ElektronikaDonBosco/Estaci-n-Meteorol-gica/README.md

# ESTACIÓN METEOROLÓGICA

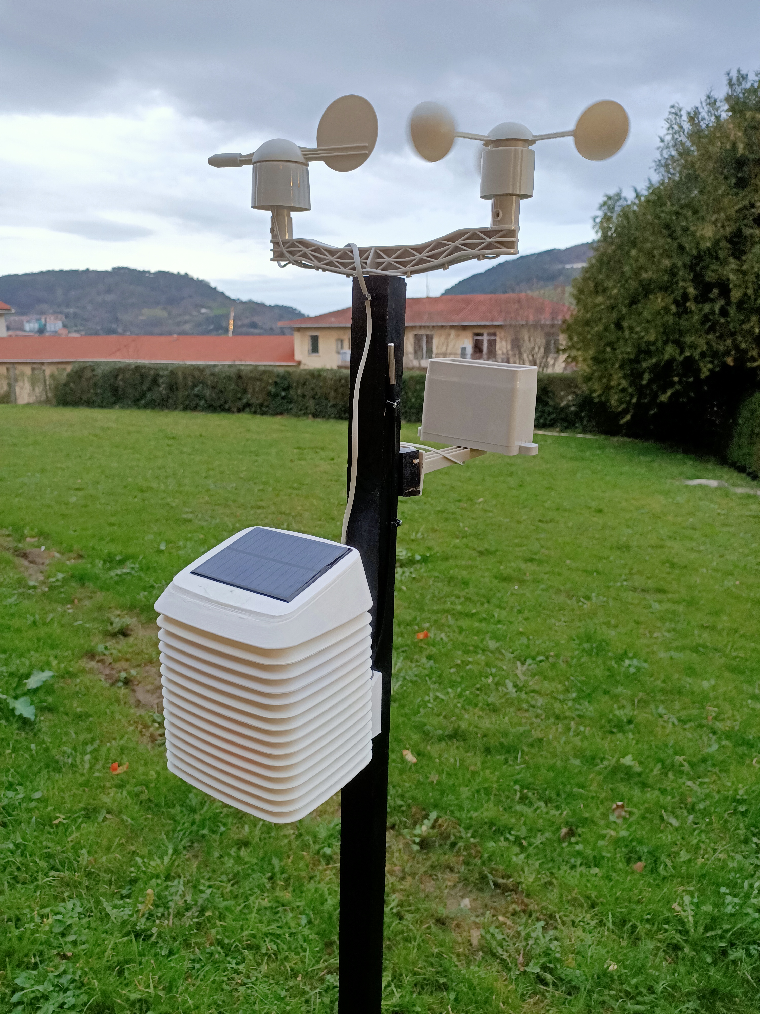
[picture p1: Foto estacion meteorologica.jpg]


## Pasos a seguir para crear una estación meteorológica
Para este proyecto  vamos a aprender cómo hacer una estación meteorológica inalámbrica alimentada mediante  energía solar , con  el uso de un módulo Wifi ESP32 y algunos sensores  lograremos tener información en tiempo real . 

La ventaja de tener una estación meteorológica es que no necesita  estar conectada a una fuente de corriente constante por lo que ahorraremos mucha energía y además puede establecerse en lugares remotos , otra ventaja que tiene es que podemos comprar estos componentes a un precio reducido con lo cual recortamos muchos gastos y hace que se muy asequible .

Para hacer posible esta estación meteorológica vamos a necesitar los siguientes componentes:

***

> **CHIPS**                     
* [BME280](https://www.amazon.com/Dmyond-Atmospheric-Pressure-Temperature-Humidity/dp/B07XKSBQ9B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) 
* [DS18B20](https://www.amazon.com/DS18B20-Temperature-Waterproof-Digital-Thermal/dp/B085WBVZHN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)
* [BH1750](https://www.amazon.com/HiLetgo-GY-302-BH1750-Intensity-Illumination/dp/B00M0F29OS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)
* [ESP32 Dev Kit V1 - 30 Pins](https://es.aliexpress.com/item/1005001757645011.html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)
* [TP4056](https://es.aliexpress.com/item/1005001562314459.html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)
* [GY1145](https://www.amazon.com/Comimark-SI1145-Visible-Sensor-Breakout/dp/B07WVJDNGF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)
* [DT1042-04SO](https://www.amazon.com/DT1042-04SO-7-Suppressor-Uni-Dir-Automotive-SOT-26/dp/B07NLKFPK7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)

***

> **RESISTENCIAS**
* **1 KΩ**  x2
* **4,7 KΩ**  x3
* **10 KΩ**  x1
* **27 KΩ**  x1
* **100 KΩ**  x1

***

> **TRANSISTORES**
* [MCP1700-3.3V](https://www.amazon.com/10PCS-MCP1702-3302E-3-3V-92-3-MCP1702/dp/B01IL71VPG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)

***

> **CONDENSADORES**

* **0.1 uF**  x2
* **1 uF**  x2
* **100 uF**  x1

***

> **COMPONENTES**
* [Wind & Rain Sensor](https://www.amazon.com/Weather-Meter-Kit-Anemometer-terminated/dp/B084DBXMPX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)
  * Wind Speed ( Sparkfun Weather Meter )
  * Wind Direction ( Sparkfun Weather Meter )
  * Rain Gauge ( Sparkfun Weather Meter )
* [RJ11 conector x2](https://es.aliexpress.com/item/32957716969.html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)
* [Cables macho/hembra arduino](https://www.amazon.com/DEPEPE-2-54mm-Headers-Arduino-Prototype/dp/B074HVBTZ4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)
* [Jumper Cap  x1](https://www.amazon.com/ZYAMY-2-54mm-Standard-Circuit-Connection/dp/B077957RN7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)
* [Panel Solar 5V / 1.2Watt (110x69 mm)](https://www.amazon.com/uxcell-Small-Module-Polysilicon-Charger/dp/B07JM399X1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)
* [Batería de 18650 ](https://es.aliexpress.com/item/1005001388830999.html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)
* [Soporte de batería 18650](https://www.amazon.com/abcGoodefg-1Slotx3-7V-Battery-Plastic-Storage/dp/B075N69BMN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,aps,366&sr=8-5&linkCode=sl1&tag=opegreene-20&linkId=c922677798d4036b3bc49ae5ca12e4c4&language=en_US&ref_=as_li_ss_tl)
* [Cables de arduino](https://www.amazon.com/Elegoo-EL-CP-004-Multicolored-Breadboard-arduino/dp/B01EV70C78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,aps,426&sr=8-1-spons&psc=1&spLa=ZW5jcnlwdGVkUXVhbGlmaWVyPUEyU1IwMjFYUUQzQTEwJmVuY3J5cHRlZElkPUEwNjY4NjU2RzRDWkE1QVFHMFdSJmVuY3J5cHRlZEFkSWQ9QTA5NDUzMjExRUtQVk9KOTU5MVg5JndpZGdldE5hbWU9c3BfYXRmJmFjdGlvbj1jbGlja1JlZGlyZWN0JmRvTm90TG9nQ2xpY2s9dHJ1ZQ%3D%3D&linkCode=sl1&tag=opegreene-20&linkId=2b274fdd7e99e5950ab9fd82304d5d3c&language=en_US&ref_=as_li_ss_tl)
* [Switch](https://www.amazon.com/Uxcell-a12013100ux0116-Position-Vertical-Switch/dp/B007QAJUUS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)

***

> **HERRAMIENTAS**
* [Estación de soldar](https://www.google.com/shopping/product/5042715519988754151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,eto:17283412033935127216_0,rsk:PC_3058408035792851722&sa=X&ved=0ahUKEwi769iqtIH2AhUGSfEDHTTRCMsQ9pwGCAU)
* [Tenazas](https://www.google.com/shopping/product/13360539414276992579?q=tenazas&prds=epd:10786235037946669078,eto:10786235037946669078_0,rsk:PC_616138079748265835&sa=X&ved=0ahUKEwi3quvFtIH2AhU4SPEDHX9oBzAQ9pwGCAU)
* [Cortante o Alicates](https://www.google.com/shopping/product/1?q=cortante&prds=epd:8859887341376829913,eto:8859887341376829913_0,pid:8859887341376829913&sa=X&ved=0ahUKEwjgp7jYtIH2AhWxRPEDHVwxBD8Q9pwGCAc)
* [Pistola de calor](https://www.lidl.es/es/pistola-digital-de-aire-caliente-2000-w/p31928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)
* [impresora 3D](https://www.banggood.com/es/Artillery-GeniusPro-and-Genius-3D-Printer-220+220+250mm-Print-Size-with-Ultra-Quiet-Stepper-Motor-TFT-Touch-Screen-Support-Filament-Runou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)
* [Estaño](https://es.rs-online.com/web/p/estano-e-hilo-de-soldar/1047189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) 

***
## MONTAJE DE LA ESTACIÓN METEOROLÓGICA
Para la creación de esta estación hemos diseñado nuestra **PCB** en la cual habrá que soldar todos los componentes mencionados arriba.

tanto los archivos de `Proteus 8`como  `Gerber X` estarán disponibles para descargar. Para el montaje y diseño nos hemos basado en esta imagen en la que se puede ver como están dispuestas las conexiones .

>**PROTEUS**
* [**ESTACION METEOROLOGICA PROGRAMA**](https://github.com/V1c7hor/Estacion-Meteorologica/tree/main/PROTEUS)

>**GERBER X**
* [**ESTACION METEOROLOGICA GERBER X**](https://github.com/V1c7hor/Estacion-Meteorologica/tree/main/GERBER%20X)

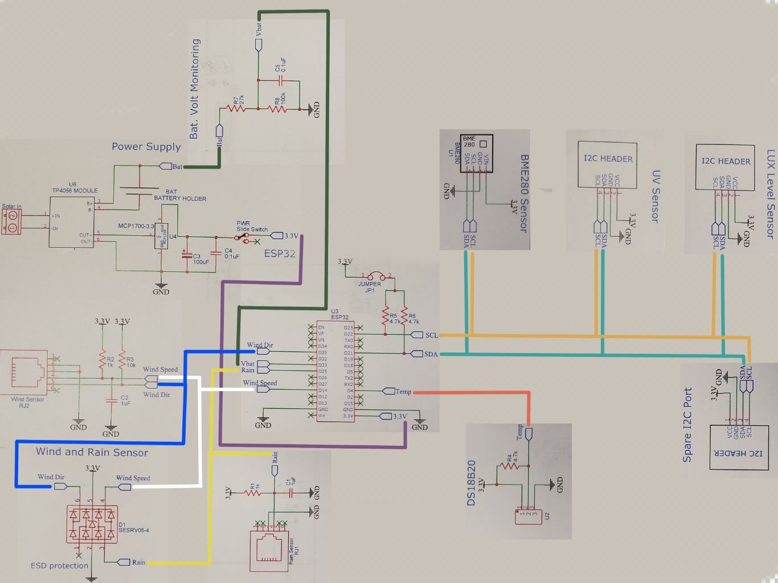
[picture p2: Captura meteorologica.JPG]


Disposición de los componentes en la **PCB** .

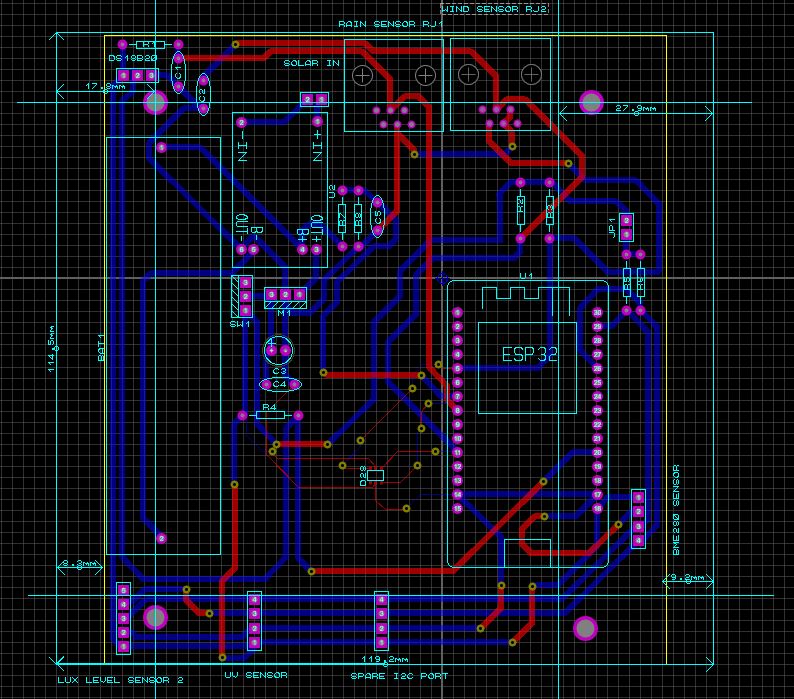
[picture p3: PROTEUS/PROTEUS CONEXIONES.JPG]

***
Para el recubrimiento de la PCB hemos utilizado una impresora 3D para este proceso, en nuestro caso es la **Artillery Genius** y hemos utilizado estos esquemas de thingiverse para ello:

>**THINGIVERSE**
* [**Piezas 3D**](https://www.thingiverse.com/thing:4805867/files)
  * **PCB_Mount_Frame** x1
  * **Bottom_Mount** x1
  * **M6_Rod_x_4** x4
  * **Top_Cover__for_Solar_Panel_Mount** x1
  * **Middle_Rings_x_12** x12
  * **Bottom_Plate** x1
  * **Screen_Top_Cover** x1

En nuestro caso el archivo de thingiverse es **.STL** por lo cual no es compatible con nuestra impresora 3D para ello hemos descargado un software libre llamado **Ultimaker Cura** para hacer que este proceso , este programa lo que hace es cambiar el archivo de **.STL** a .**gcode** el cual si es compatible para nuestra impresora. Descargar la versión  mas conveniente para vuestro ordenador ya sea **Windows** , **linux** o **Mac**. 

> **ULTIMAKER CURA**
* [**Pagina Web**](https://ultimaker.com/es/software/ultimaker-cura)

Una vez descargado el programa abriremos el archivo **.STL** y en la parte de abajo a la derecha donde pone **`slice`** le damos y nos pondrá el nuevo archivo **gcode** además de la duración que tardaremos en imprimir la pieza . Después de esto cogeremos un **USB** y pondremos en la impresora .
Nos saldrá un menú como este en nuestra impresora al encenderla ,le daremos a **`Print`** y elegiremos el archivo que queramos imprimir.



Una vez impresas todas  las piezas las montaremos hasta tener este resultado:
Para la parte superior de la estación pondremos la placa solar en la parte superior y la pegaremos con silicona , también pegaremos en el la parte superior el chip **`GY1145`** .





***

## PROGRAMA ARDUINO

Para el programar de esta estación meteorológica hemos utilizado un programa de software libre llamado Arduino . Para que el  **`ESP32 Dev Kit V1`**  funcione correctamente vamos a tener que instalar varias librerías.

>**ARDUINO**

* [**Pagina Web**](https://www.arduino.cc/en/software)

Para descargar librerías iremos a los enlaces de abajo y donde pone **CODE** haremos click y descargaremos el archivo **`.ZIP`**


>**LIBRERIAS**
* [**ESP32**](https://github.com/espressif/arduino-esp32)
* [**BME280**](https://github.com/finitespace/BME280)
* [**Adafruit**](https://github.com/adafruit/Adafruit_SI1145_Library)
* [**BH1750**](https://github.com/claws/BH1750)
* [**One Wire**](https://github.com/PaulStoffregen/OneWire)
* [**Dallas Temperature**](https://github.com/milesburton/Arduino-Temperature-Control-Library)

Una vez descargada la librería **`.ZIP`**  abriremos Arduino y nos iremos al apartado de programa , dentro de este seleccionaremos incluir librería y de daremos click en añadir librerías .zip como se puede ver en la imagen de abajo. Se nos abrirá una ventana le daremos a **`este equipo`** y luego a **`descargas`** y seleccionamos nuestro archivo **`.ZIP`** para poder instalarlo . 




Después de esto faltaría añadir un gestor de tarjetas para esto nos iremos a **`archivo`** y dentro seleccionaremos la opción de **`preferencias`** 
 , también si se prefiere se puede usar el comando **`Ctrl+Coma`**  . Una vez echo esto donde pone gestor de tarjetas añadiremos el enlace **URL** y le daremos al **`ok`** .

> **GESTOR DE TARJETAS**
* [**ESP32**](https://raw.githubusercontent.com/espressif/arduino-esp32/gh-pages/package_esp32_index.json)



***

**`Programa de Arduino Estación Meteorológica`** [**Github**](https://github.com/V1c7hor/Estacion-Meteorologica/blob/main/Weather_Station_VA.ino)

Seguidamente de descargar el programa vamos a **`herramientas`** y nos aseguramos de que la placa es la **`ESP32 Dev Module`**
***


Luego de hacer este paso dentro del código de Arduino insertaremos tanto nuestro **Wifi** nombre y contraseña y nuestro **`Write API key`** que se explicara como sacar ese codigo en el apartado de la conexión Thingspeak . 
  
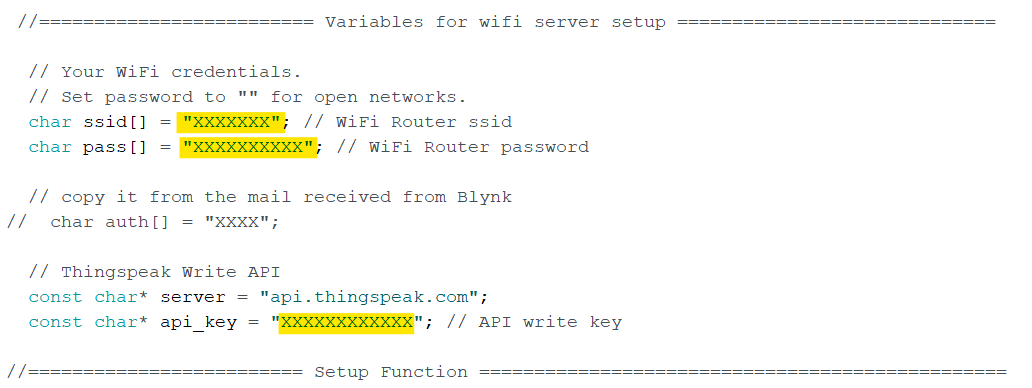
[picture p4: arduino captura.png]
foto


***

## CONEXION CON THINGSPEAK

Para este paso nos crearemos nuestra cuenta en thingspeak . Después de crear la cuenta nos iremos a **`channel`** y dentro seleccionaremos **`Mychannel`** , aquí crearemos nuestros fields en los que pondremos las caracteristicas de cada sensor del 1 al 8 como se muestra debajo.

>**THINGSPEAK**
* [**Pagina Web**](https://thingspeak.com/) 



En la que tendremos que poner los siguientes datos :

**1. Temperature**
 
**2. Humidity**

**3. Pressure**
   
**4. UV Index** 

**5. Wind Speed**

**6. Wind Direction**

**7. Rain Fall** 

**8. Battery Voltage**

Una vez echo esto iremos arriba al apartado **`API KeY`** y copiaremos el **`Write API key`** para luego ponerlo en el programa de Arduino y así hacer la comunicación.

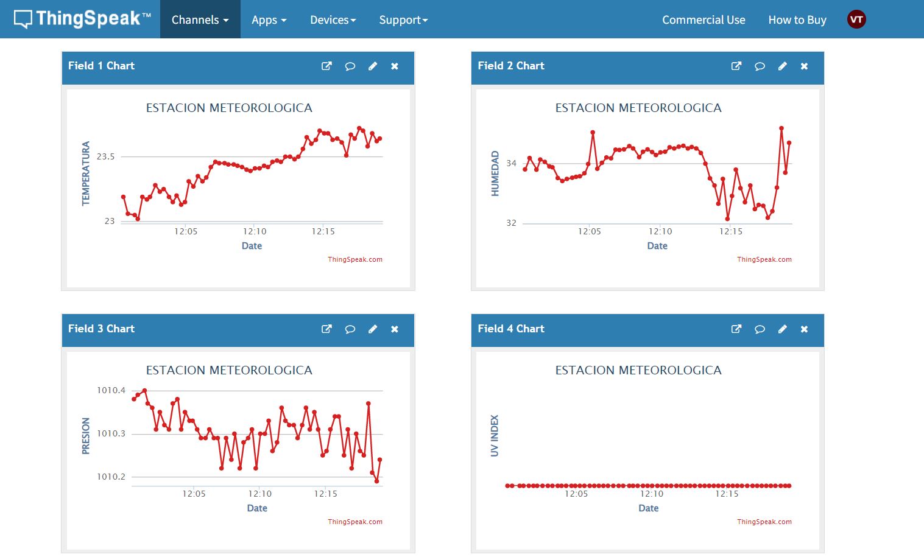
[picture p5: estacion mm.JPG]


Con esto ya estaría funcional nuestra estación meteorológica.

***
