ElektronikaDonBosco/Estaci-n-Meteorol-gica/estacion meteorologica.jpg

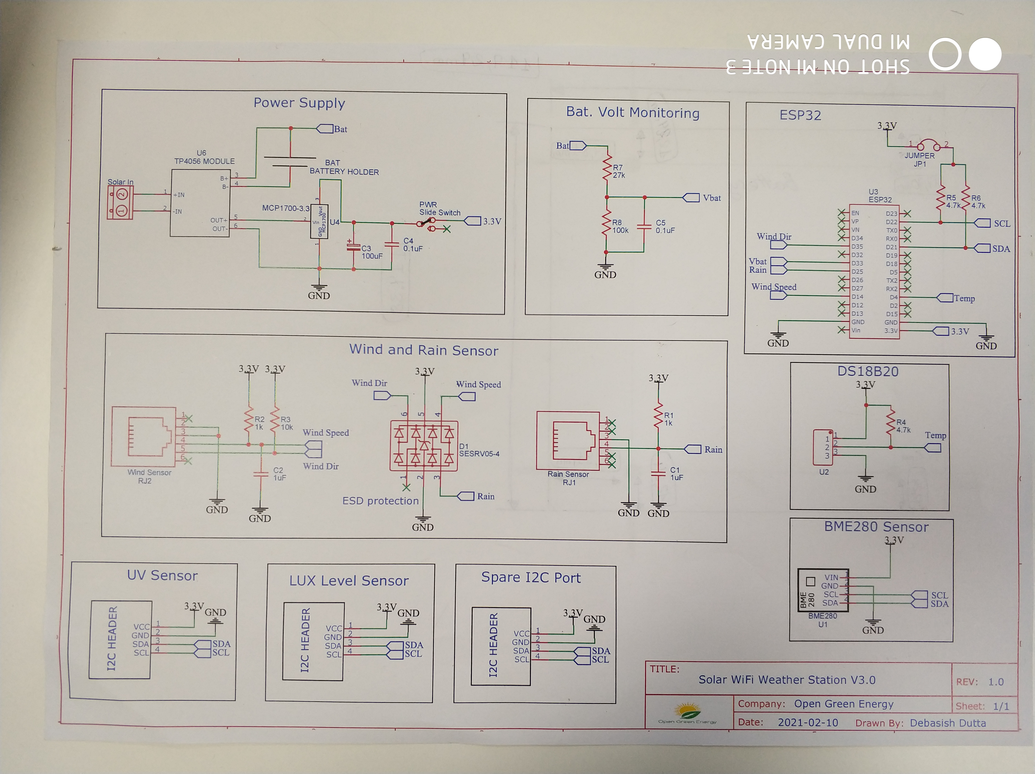
estacion meteorologica.jpg
