ElektronikaDonBosco/Estaci-n-Meteorol-gica/(list of files, drawings)

Other design files:
PROTEUS/ESTACION METEOROLOGICA PROTEUS.pdsprj
