ElektronikaDonBosco/Estaci-n-Meteorol-gica/(commit log)

2022-02-17 Create geRBER
2022-02-17 Create GERBER
